ErikDorstel/leoPlayer/(commit log)

2024-11-06 improved power distribution
2024-11-06 improved battery chart
2024-11-08 improved battery management
2024-11-10 added physical on/off switch
2024-11-16 changed button order
